balazsracz/gameoflife/hardware/BOM for GoL board.xlsx

Item # | *Designator | *Qty | Manufacturer | *Mfg Part # | Description / Value | *Package/Footprint | value | Type | Sub OK? | Your Instructions / Notes
1 | C1, C2, C3, C7, C8 | 5 | any | any | CAP CER 1UF 10V X5R 0603 +-20% | C0603 |  | SMD | Yes | Accepted substitution: X7R OK, higher voltage OK, tolerance +-20% +-10% or +-5% OK.
2 | R11, R13, R14, R15, R16, R17, R18, R19 | 8 | any | any | RES 10k OHM 0603 1/10W 5% | R0603 | 10k | SMD | Yes | Accepted substitution: 1% OK, higher wattage OK.
3 | J2 | 1 | Adam Tech | MCR-B-S-RA-TSMT-NP-CS4-T/R | MICRO USB, TYPE B, RIGHT ANGLE | micro usb | 2057-MCR-B-S-RA-TSMT-NP-CS4-T/RCT-ND | SMD | Yes | Digi-Key: 2057-MCR-B-S-RA-TSMT-NP-CS4-T/RCT-ND, example substitution: 609-5379-1-ND
4 | R12 | 1 | any | any | RES 1M OHM 0603 1/10W 5% | R0603 | 1M | SMD | Yes | Accepted substitution: 1% OK, higher wattage OK.
5 | C4, C5, C6 | 3 | any | any | CAP CER 47nF 10V X5R 0603 +-10% | C0603 | 47nF | SMD | Yes | Accepted substitution: X7R OK, higher voltage OK, tolerance +-10% or +-5% OK.
6 | U2 | 1 | Diodes Incorporated | AP2111H-3.3TRG1 | Linear Voltage Regulator IC Positive Fixed 1 Output 600mA SOT-223-3 | SOT-223_DIO-M | AP2111H-3.3TRG1SOT-223_DIO-M | SMD | No | For a proposed substitution, contact me with part number.
7 | U1 | 1 | ST Microelectronics | STM32F072CBT | IC MCU 32BIT 128KB FLASH 48LQFP | LQFP48-7X7MM | STM32F072CBT | SMD | No
8 | BTN1,BTN2,BTN3,BTN4,BTN5,BTN6,BTN7,BTN8,BTN9,BTN10,BTN11,BTN12,BTN13,BTN14,BTN15,BTN16,EAST,BTN17,D1,D2,D3,D4,D5,D6,D7,D8,D9,D10,D11,D12,D13,D14,D15,D16,BTN18,NORTH,R1,R2,R3,R4,R5,R6,R7,R8,R9,R10,BTN19,SOUTH,J1,WEST |  |  |  |  |  |  | DNP |  | Do not populate
