balazsracz/gameoflife/hardware/gol.pdf

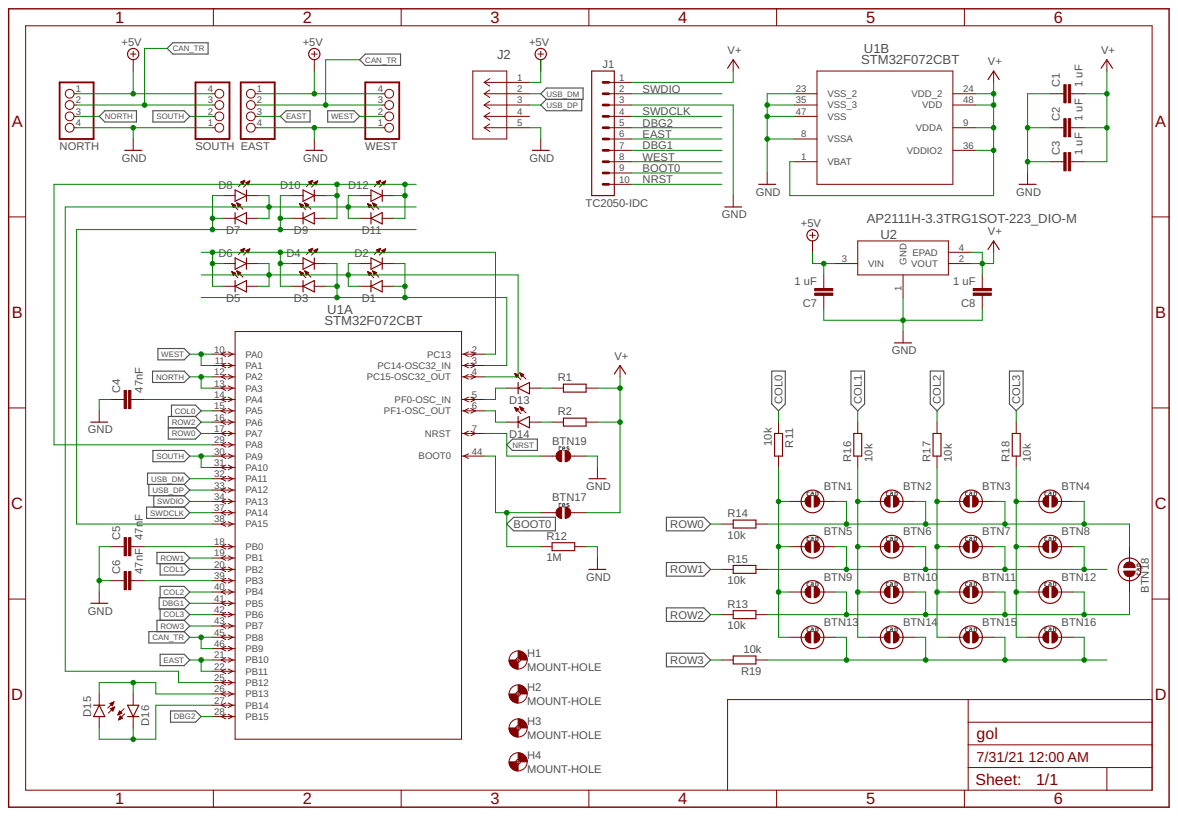
[picture p1: page 1]
