balazsracz/gameoflife/hardware/reva/gol.pdf

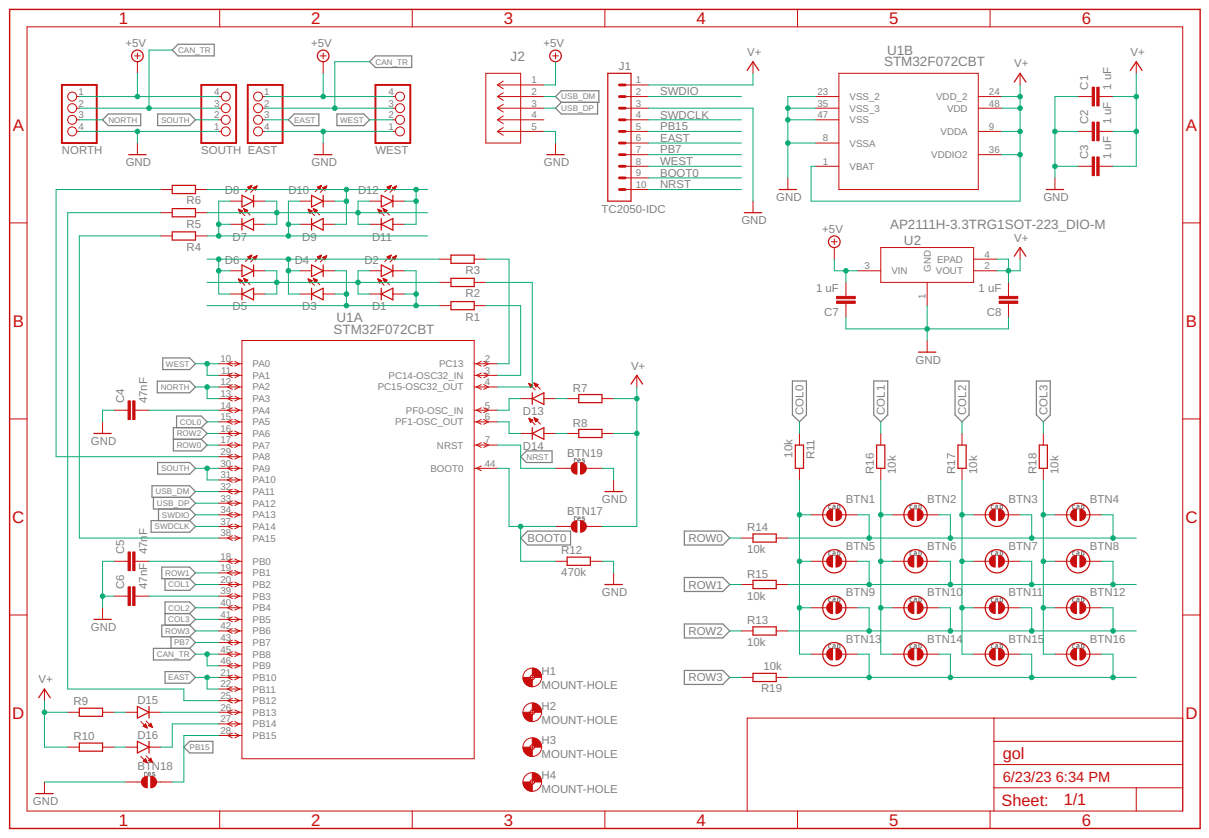
[picture p2: page 1]
