balazsracz/gameoflife/hardware/gol.brd

## EAGLE design hardware/gol.brd (2023-07-31)

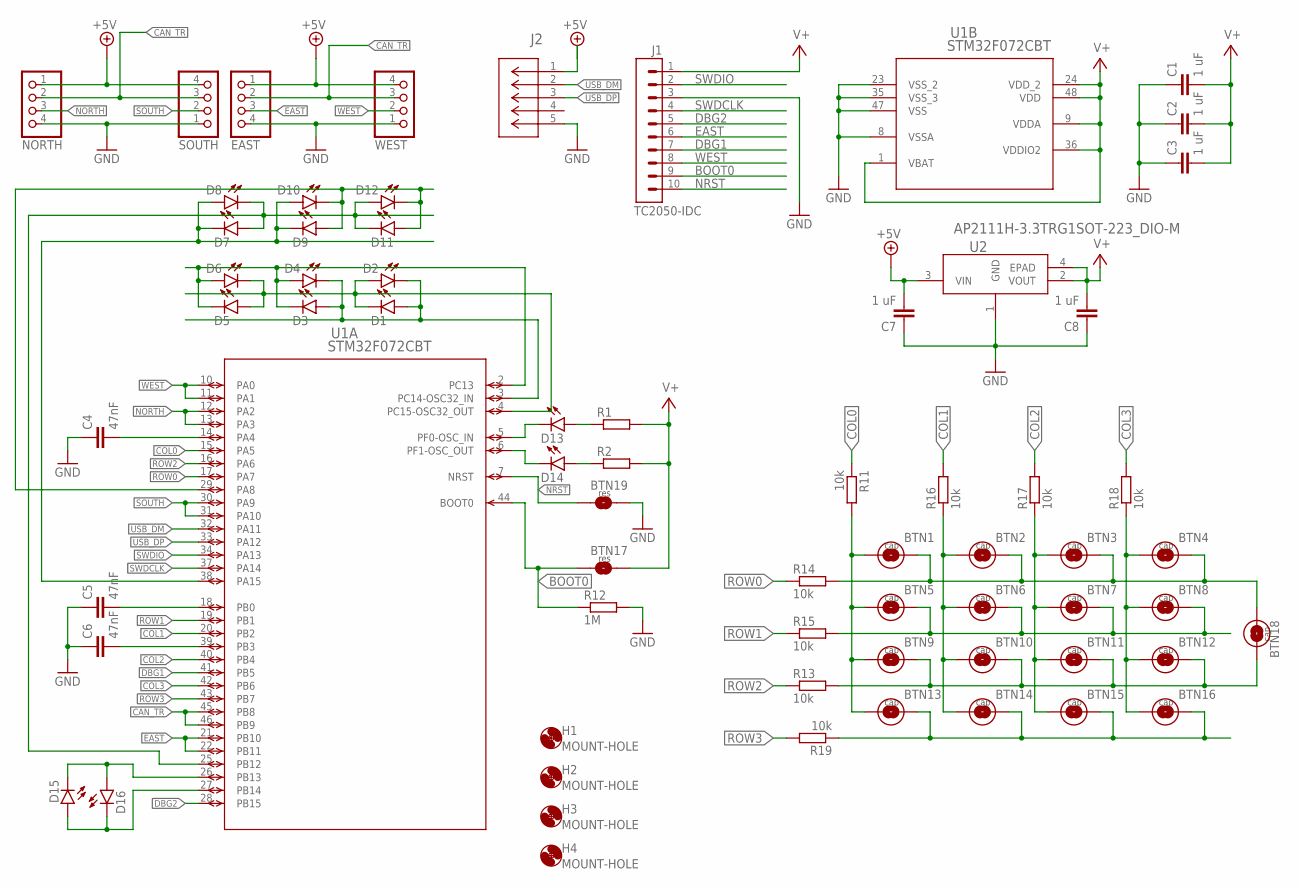
[picture p3: schematic gol.sch]

Parts:
BTN1: 1; COMB
BTN2: 2; COMB
BTN3: 3; COMB
BTN4: 4; COMB
BTN5: 5; COMB
BTN6: 6; COMB
BTN7: 7; COMB
BTN8: 8; COMB
BTN9: 9; COMB
BTN10: 10; COMB
BTN11: 11; COMB
BTN12: 12; COMB
BTN13: 13; COMB
BTN14: 14; COMB
BTN15: 15; COMB
BTN16: 16; COMB
BTN17: FLASH; COMB_EXPOSED
BTN18: MENU; COMB_NARROW
BTN19: RESET; COMB_EXPOSED
C1, C2, C3, C7, C8: 1 uF; C0603
C4, C5, C6: 47nF; C0603
D1, D2, D3, D4, D5, D6, D7, D8, D9, D10, D11, D12, D13, D14, D15, D16: LED-5MM; LED5MM
EAST: EAST; 1X04
H1, H2, H3, H4: MOUNT-HOLE; MOUNT-HOLE-2,8
J1: TC2050-IDC
J2: 2057-MCR-B-S-RA-TSMT-NP-CS4-T/RCT-ND; CONN_10118192-0002LF_AMP; DIGIKEY_PART_1 609-5379-1-ND
NORTH: NORTH; JP4-RA-FEM
R1, R2: R-EU-0207/8; 0207/8
R11, R13, R14, R15, R16, R17, R18, R19: 10k; R0603
R12: 1M; R0603
SOUTH: SOUTH; 1X04/90
U1: STM32F072CBT; LQFP48-7X7MM
U2: AP2111H-3.3TRG1SOT-223_DIO-M; SOT-223_DIO-M
WEST: WEST; 1X04

Connections:
+5V: C7.2, EAST.1, J2.1, NORTH.1, SOUTH.4, U2.3 (VIN), WEST.4
BOOT0: BTN17.P$1 (1), J1.9, R12.1, U1.44 (BOOT0)
CAN_TR: EAST.2, NORTH.2, SOUTH.3, U1.45 (PB8), U1.46 (PB9), WEST.3
COL0: R11.1, U1.15 (PA5)
COL1: R16.2, U1.20 (PB2)
COL2: R17.2, U1.40 (PB4)
COL3: R18.2, U1.42 (PB6)
DBG1: J1.7, U1.41 (PB5)
DBG2: J1.5, U1.28 (PB15)
EAST: EAST.3, J1.6, U1.21 (PB10), U1.22 (PB11)
GND: BTN19.P$2 (2), C1.1, C2.1, C3.1, C4.1, C5.1, C6.1, C7.1, C8.1, EAST.4, J1.3, J2.5, NORTH.4, R12.2, SOUTH.1, U1.8 (VSSA), U1.23 (VSS_2), U1.35 (VSS_3), U1.47 (VSS), U2.1 (GND), WEST.1
IN_COL0: BTN1.P$1 (1), BTN5.P$1 (1), BTN9.P$1 (1), BTN13.P$1 (1), R11.2
IN_COL1: BTN2.P$1 (1), BTN6.P$1 (1), BTN10.P$1 (1), BTN14.P$1 (1), R16.1
IN_COL2: BTN3.P$1 (1), BTN7.P$1 (1), BTN11.P$1 (1), BTN15.P$1 (1), R17.1
IN_COL3: BTN4.P$1 (1), BTN8.P$1 (1), BTN12.P$1 (1), BTN16.P$1 (1), R18.1
IN_ROW0: BTN1.P$2 (2), BTN2.P$2 (2), BTN3.P$2 (2), BTN4.P$2 (2), BTN18.P$1 (1), R14.2
IN_ROW1: BTN5.P$2 (2), BTN6.P$2 (2), BTN7.P$2 (2), BTN8.P$2 (2), R15.2
IN_ROW2: BTN9.P$2 (2), BTN10.P$2 (2), BTN11.P$2 (2), BTN12.P$2 (2), BTN18.P$2 (2), R13.2
IN_ROW3: BTN13.P$2 (2), BTN14.P$2 (2), BTN15.P$2 (2), BTN16.P$2 (2), R19.1
unnamed: C4.2, U1.14 (PA4)
unnamed: C5.2, U1.18 (PB0)
unnamed: C6.2, U1.39 (PB3)
unnamed: D13.A, R1.1
unnamed: D14.A, R2.1
NORTH: NORTH.3, U1.12 (PA2), U1.13 (PA3)
NRST: BTN19.P$1 (1), J1.10, U1.7 (NRST)
OUTA-L1: D3.K (C), D4.A, D5.K (C), D6.A, U1.2 (PC13)
OUTA-L2: D1.A, D2.K (C), D3.A, D4.K (C), U1.3 (PC14-OSC32_IN)
OUTA-L3: D1.K (C), D2.A, D5.A, D6.K (C), U1.4 (PC15-OSC32_OUT)
OUTB-L1: D7.K (C), D8.A, D9.K (C), D10.A, U1.38 (PA15)
OUTB-L2: D7.A, D8.K (C), D11.K (C), D12.A, U1.25 (PB12)
OUTB-L3: D9.A, D10.K (C), D11.A, D12.K (C), U1.29 (PA8)
OUTD13: D13.K (C), U1.5 (PF0-OSC_IN)
OUTD14: D14.K (C), U1.6 (PF1-OSC_OUT)
OUTD15: D15.K (C), D16.A, U1.26 (PB13)
OUTD16: D15.A, D16.K (C), U1.27 (PB14)
ROW0: R14.1, U1.17 (PA7)
ROW1: R15.1, U1.19 (PB1)
ROW2: R13.1, U1.16 (PA6)
ROW3: R19.2, U1.43 (PB7)
SOUTH: SOUTH.2, U1.30 (PA9), U1.31 (PA10)
SWDCLK: J1.4, U1.37 (PA14)
SWDIO: J1.2, U1.34 (PA13)
USB_DM: J2.2, U1.32 (PA11)
USB_DP: J2.3, U1.33 (PA12)
V+: BTN17.P$2 (2), C1.2, C2.2, C3.2, C8.2, J1.1, R1.2, R2.2, U1.1 (VBAT), U1.9 (VDDA), U1.24 (VDD_2), U1.36 (VDDIO2), U1.48 (VDD), U2.2 (VOUT), U2.4 (EPAD)
WEST: J1.8, U1.10 (PA0), U1.11 (PA1), WEST.2

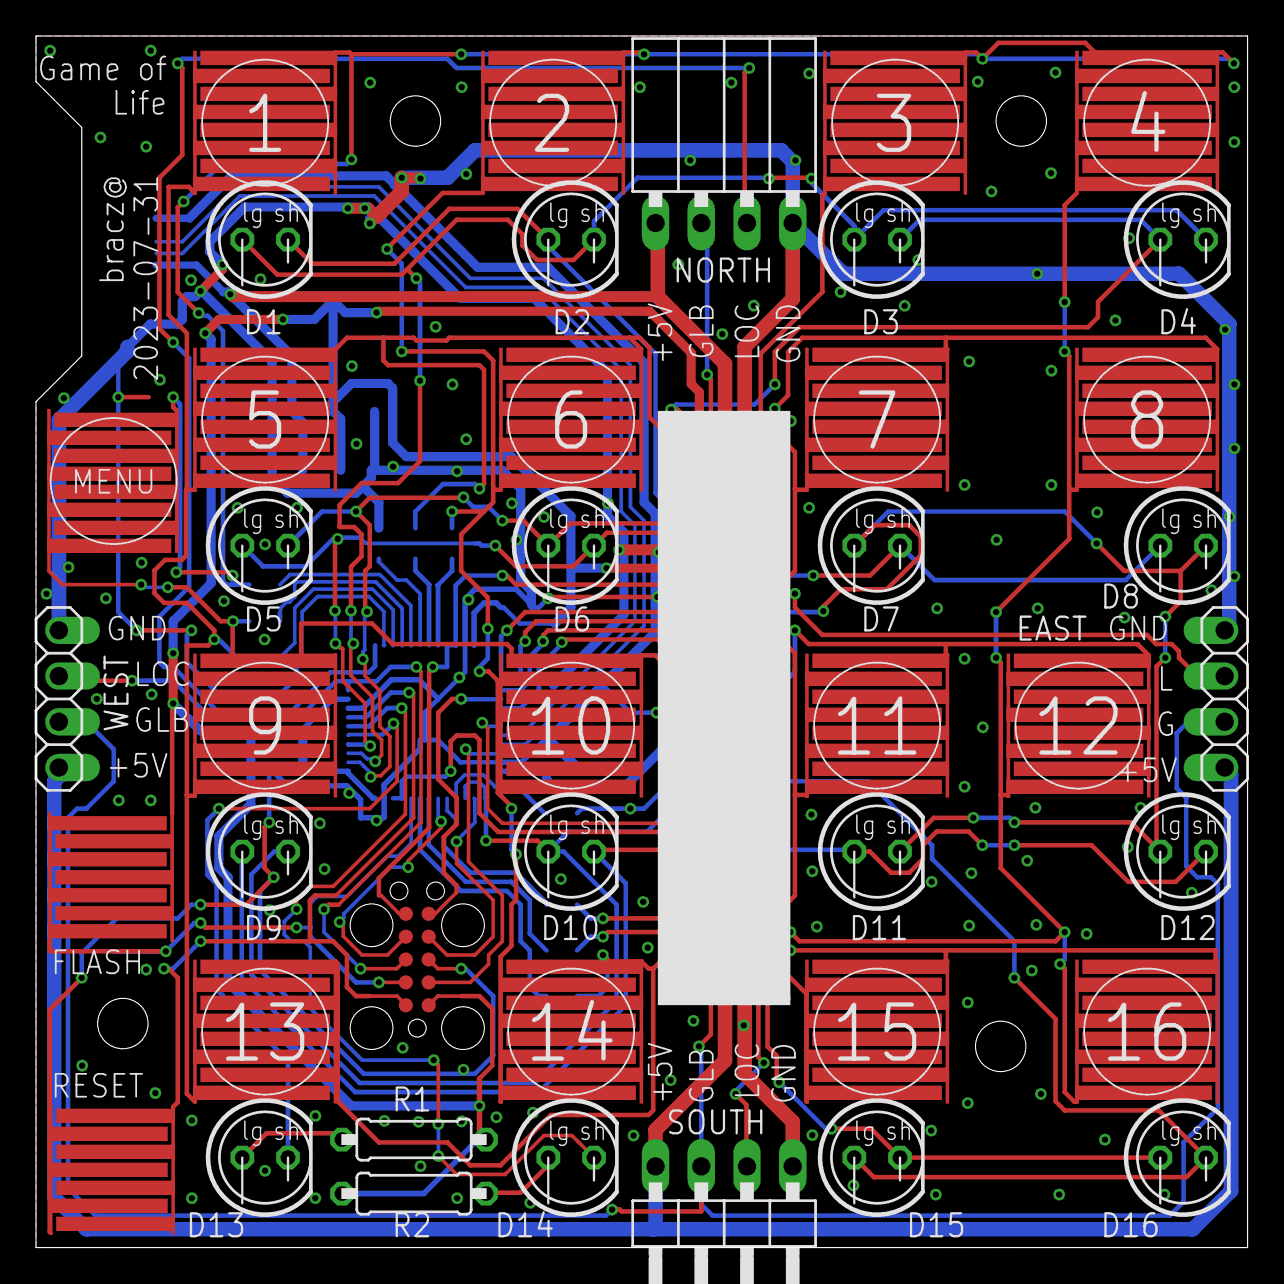
[picture p4: board gol.brd from above]

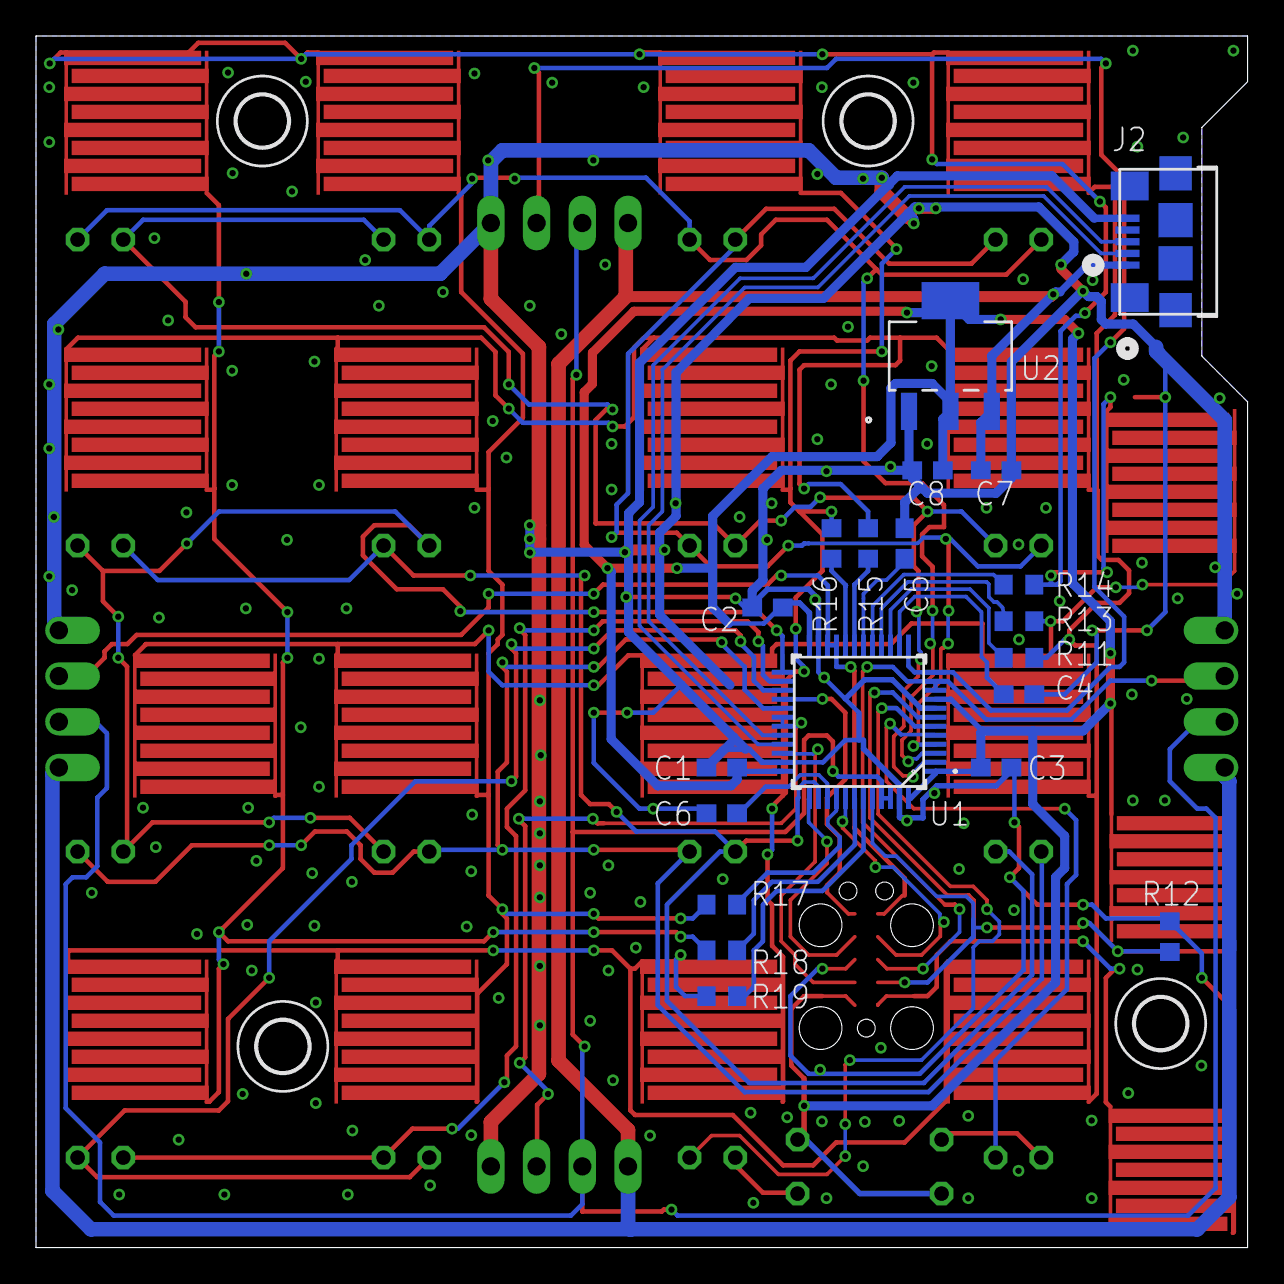
[picture p5: board gol.brd from below]

Board: 2 copper layers, 67.3 x 67.3 mm, 66 parts (24 on the bottom side), 47 nets.
