balazsracz/gameoflife/(commit log)

2023-06-10 Adds library with custom parts. Adds most components to the schematic.
    [gol.sch]
2023-06-11 Adds buttons and LEDs, adds schematic for grids.
    [gol.sch]
2023-06-11 Adds micro-usb connector and 5V to 3V3 voltage regulator.
    [gol.sch]
2023-06-19 Adds board layout file.
    [gol.brd]
2023-06-19 Adds resistor 0207/8 footprint and device.
2023-06-19 Completes layout of top side components. Adds +12V grid horizontally.
    [gol.brd, gol.sch]
2023-06-19 Completes part of the layout and a small part of the routing around the MCU.
    [gol.brd, gol.sch]
2023-06-20 Adds edge-of-board to the mini-usb connector. Routes the USB lines.
    [gol.brd, gol.sch]
2023-06-20 more routing
    [gol.brd, gol.sch]
2023-06-22 more routing work
    [gol.brd, gol.sch]
2023-06-22 Prep for rearranging the capacitive inputs.
    [gol.brd]
2023-06-22 Finishes rerouting the row/col ports
    [gol.brd, gol.sch]
2023-06-22 more routing.
    [gol.brd, gol.sch]
2023-06-23 Finishes routing most of the LEDs.
    [gol.brd]
2023-06-23 Fixes routing of missing gnd lines.
    [gol.brd]
2023-06-23 Adds 4-pin connector to east and west as well. Routes all remaining airwires.
    [gol.brd, gol.sch]
2023-06-23 Places parts labels on top and bottom layer.
    [gol.brd, gol.sch]
2023-06-23 more labeling work. Updates parts so that they have outlines.
    [gol.brd, gol.sch]
2023-06-23 Adds ground pour and vias.
    [gol.brd]
2023-06-23 fills in an orphan
    [gol.brd]
2023-06-23 adds right-angle female header. replaces north with this.
    [gol.brd, gol.sch]
2023-06-23 Realigns the north connector with the edge. Updates some ground vias.
    [gol.brd]
2023-06-23 Adds more labels.
    [gol.brd]
2023-06-23 Adds BOM export file.
    [bom.csv]
2023-06-23 Adds processed BOM.
    Source:
    https://docs.google.com/spreadsheets/d/1hPsUb-Z08cYV5bmjL9kkSWupxSgmaA6F4GPnxTLXvis/edit#gid=1399560954
    Source:
    https://docs.google.com/spreadsheets/d/1w2xxuD-KHHd0Ks5WC5oyJ4qTA2DeoRDwIQumlcHQEdU/edit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
    [BOM for GoL board.xlsx]
2023-06-23 Fixes DRC errors, approves false positives.
    [gol.brd]
2023-06-23 Updates the mounting hole to take less floorspace.
    Adds four mounting holes to the device. Rearranges some wires and vias to make it work.
    [gol.brd, gol.sch]
2023-06-23 Change author label.
    [gol.brd]
2023-06-26 Adds gerber and assembly files for prototype run. Adds missing values for the pnp render. Adds a rendered pdf schematic.
    [gol.brd, gol.sch]
2023-07-10 Adds an empty sketch that runs on the GoL board for testing various hardware features.
2023-07-10 Adds example of how to use a hardware timer with the arduino API.
2023-07-17 Fork hardware/gol.sch to hardware/reva/gol.sch
    [gol.sch]
2023-07-17 Fork hardware/gol.sch to hardware/reva/gol.sch step 4
    [gol.sch]
2023-07-17 Fork hardware/gol.brd to hardware/reva/gol.brd
    [gol.brd]
2023-07-17 Fork hardware/gol.brd to hardware/reva/gol.brd step 4
    [gol.brd]
2023-07-17 Adds reva schematic to the backup dir.
2023-07-17 Moves the capacitive sensors from PB5-6 to PB6-7. Switches the debug output from PB7 to PB5.
    [gol.brd, gol.sch]
2023-07-17 Replaces the menu button with capacitive option. Adds cirles and numbers to the capacitive buttons.
    [gol.brd, gol.sch]
2023-07-17 Moves some labels so that they don't overlap with the cap buttons.
    [gol.brd]
2023-07-18 Temprarily disables charlieplexing to test LEDs.
2023-07-19 Makes the CAN-bus controller work.
2023-07-19 removes R1..R3 from one of the charlieplexing ranges.
    [gol.brd, gol.sch]
2023-07-19 Removes R4-R6 for charlieplexing B.
    [gol.brd, gol.sch]
2023-07-19 Moves D15/16 to a two-way charlieplexing.
    [gol.brd, gol.sch]
2023-07-19 Layer visibility update.
    [gol.brd]
2023-07-19 Update board date.
    [gol.brd]
2023-07-19 Moves some labels because they overlapped the part's pad.
    [gol.brd]
2023-07-19 Moves the menu label into the circle.
    [gol.brd]
2023-07-19 Updates visible label to not overlap button 1. Adds gerbers.
    [gol.brd]
2023-07-21 Adds proper implementation of charlieplexing.
    Adds a minimal UI to test out a bunch of different LEDs.
2023-07-21 Fixes ghosting in the charlieplex handler.
    [Test.ino]
2023-07-23 Adds full assignment of all LEDs.
2023-07-30 Updates schematic for rev 2.
2023-07-30 Updates the pin map for the touch channels on rev 2 board.
2023-07-31 Mirrors the holes to the bottom layer.
    [gol.brd]
2023-07-31 Changes thickness of labels on the touch buttons.
    [gol.brd, gol.sch]
2023-07-31 Bump date code to 07-31
    [gol.brd]
2023-07-31 Removes opening in soldermask and cream from the comb-resistive button footprint.
    [gol.brd, gol.sch]
2023-07-31 Adds final gerbers and assembly file.
2023-07-31 Updates pads of the LQFP48 to be 11 mil wide instead of 12mil. The board house needs more clearance between pads.
    [gol.brd, gol.sch]
2023-10-03 Adds rev C gerbers and BOM updates.
    [BOM for GoL board.xlsx, PnP_gol_back.csv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]
2023-10-04 Completes touch sensor helper code. Adds timer helper code. Adds missing hal_conf_extra file.
2023-10-04 Adds example that blinks the two LEDs.
2023-10-04 Adds charlieplexing implementation. Fixes some bugs on the TCS peripehral driver.
2023-10-05 Updates PDF from latest schematic.
2023-10-06 Adds global bus, a CAN driver and an example code exercising frame send and receive.
2023-10-09 Fixes alias conflict handling a bit.
    [global-bus.h]
2023-10-13 Switches over the ID program code to work independently of USB and faster.
2023-10-13 Adds tx and tx LEDs to the can-usb sketch.
2023-10-13 Fixes a nullptr dereference upon startup.
    [protocol-engine.h]
2023-10-13 Fixes initialization bug in the CAN frame structure.
    [global-bus.h]
2023-10-13 Fix some race conditions with election.
    [protocol-engine.h]
2023-10-13 fix bug in debunk.
    [protocol-engine.h]
2023-10-13 Fixes bug in TX busy.
    [UsbCan.ino, global-bus.h]
2023-10-13 Makes the RX activity LED blink longer.
2023-10-13 Fixes in leader election code.
    [protocol-engine.h]
2023-10-14 Fixes state machine of full discovery. Implements catchup discovery.
    [protocol-defs.h, protocol-engine.h]
2023-10-15 Fixes some bugs: - initializing the disc_state_ variable. - report neighbors did not correctly loop and terminate - There was a spurious local assign command left in the state after discovery was don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
    Adds a report neighbors call after discovery.
    [protocol-engine.h]
2023-10-15 Adds actual iteration of the game on a single board.
    Adds remote control for
    - start, stop iteration
    - set random state
2023-10-15 Adds implementation of watching neighbor state. Fixes bug in remote start/stop iteration. It should only apply to a leader.
    [protocol-defs.h, protocol-engine.h]
2023-10-16 Simplifies the state machine since we can now enqueue events with correct loopback.
    [protocol-engine.h]
2023-10-16 Adds implementation of dead board detection.
2023-11-06 Fixes some bugs in the leader election protocol to make it more robust. Fixes bug in the dead plane detection. Only the leader should ever run the dead plane detection.
    [global-bus.h, protocol-engine.h]
2023-11-12 Fixes hash aggregation of the global state.
    [protocol-engine.h]
2023-11-17 Makes it possible to run a single board alone.
    This is accomplished by looking for bus off condition on the CAN-bus,
    and canceling transmit frames after a msec when a bus off is detected.
2023-11-20 Adds a mechanism to report the calibration data from the touch sensor.
2023-11-20 Adds a button combination to enter the bootloader via menu+16.
2023-11-20 Adds support for processing and sending buttons.
2023-11-20 Adds implementation of global menu functions. Adds a couple of debugging features.
2023-11-22 Adds unit test framework and an example unittest.
2023-12-05 Fixes bug when the stopped iteration was restarted and the tick timeout is in the past.
    [protocol-engine.h]
2023-12-05 Implements evolution speed menu buttons.
2023-12-11 delays election by 500 msec after startup. The goal is to allow a big board to settle before starting an election.
2023-12-11 Replaces menu blink with a full pattern that the engine can show on the leds.
    [protocol-engine.h]
2023-12-11 Lights up the master LEDs during discovery.
2023-12-12 Adds missing initialization to election start tick timeout.
    [protocol-engine.h]
2023-12-12 Makes menu button 9 reinit the whole board.
2023-12-12 Fixes unwanted restarts after discovery.
    [protocol-engine.h]
2023-12-12 Makes the menu blinks blink dark as well, even if state is true for the given LED. Makes the second page menu blink double the speed.
2023-12-12 Adds workarounds for infinite loops during startup. A full re-discover will not reinit all boards anymore. A local address conflict will overwrite the board's address instead of leaving the old addre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
    [protocol-engine.h]
2023-12-12 Fix bug when a node was added to the queue with address FFFF.
    [protocol-engine.h]
2023-12-12 Fix sketch main file names.
    [CzProd.ino, VdProd.ino]
2023-12-12 Replace duplicate files with symlinks.
    [global-bus.h, protocol-defs.h, protocol-engine.h]
2023-12-12 Fix compile error due to API change in the engine.
    [CzProd.ino]
2023-12-12 Fixes a bug in CZ implementation. The State Set and State Or commands were executed indiscriminate of the target coordinates.
    [CzProd.ino]
2023-12-13 Optimize the CAN timing for short bus but high oscillator skew.
    [global-bus.h]
2023-12-13 Fixes conflict on firmware update complete vs report calibration. Updates the default iteration speed to 0.5 seconds.
    [protocol-defs.h]
2023-12-13 Adds reports to the leader job to debug failures in communication: - reports the number of nodes that checked in with state at each iteration - reports the number of times loop() got executed - repor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
    [protocol-defs.h, protocol-engine.h]
